fran-byte/MagSenseUI/doc/1.jpg

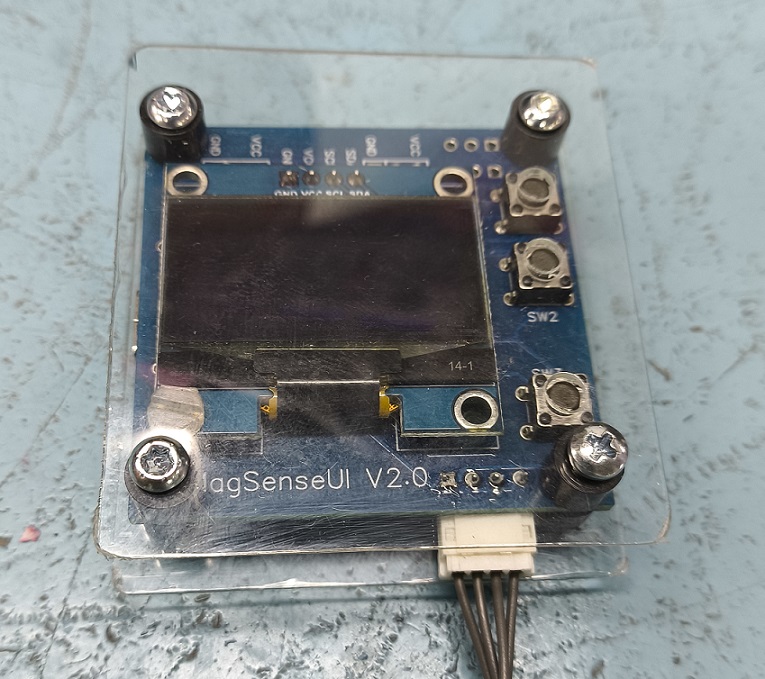
doc/1.jpg
