fran-byte/MagSenseUI/doc/3.jpg

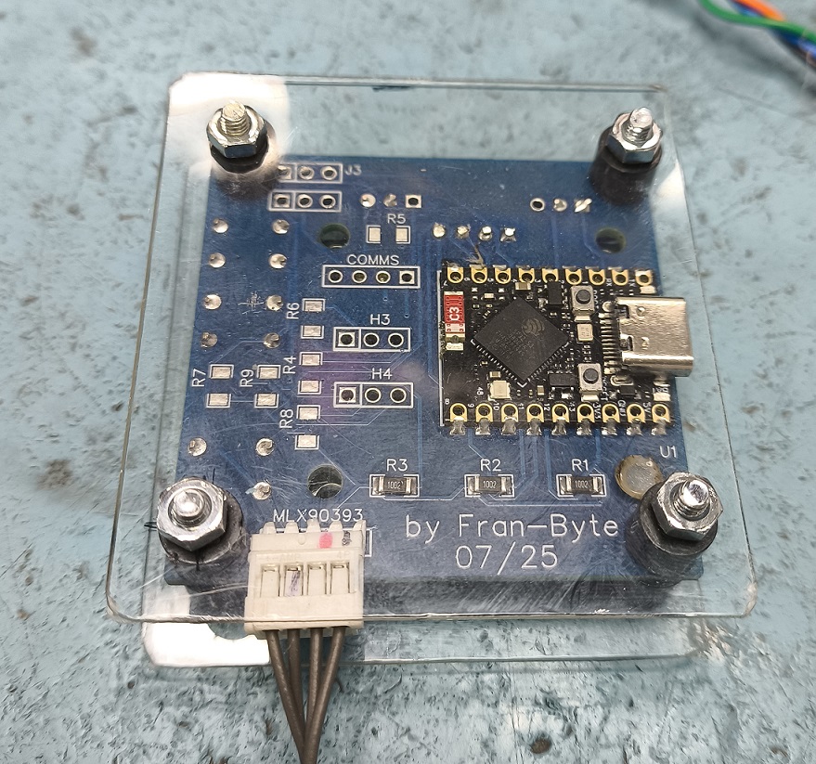
doc/3.jpg
