fran-byte/MagSenseUI/doc/3d.png

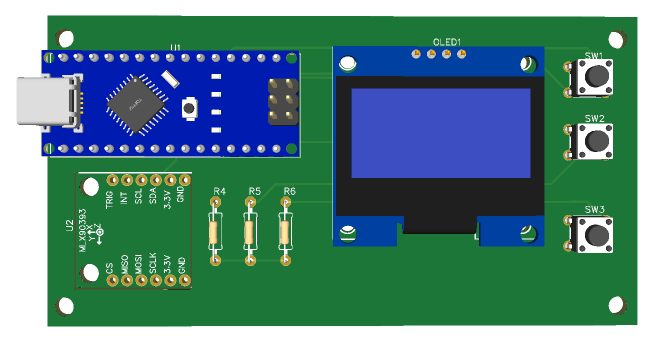
doc/3d.png
