fran-byte/MagSenseUI/doc/mlx90393.jpg

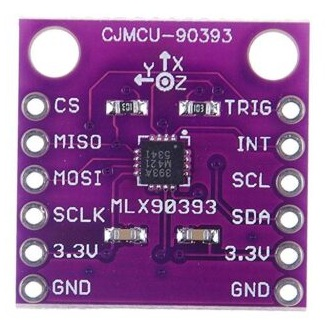
doc/mlx90393.jpg
