fran-byte/MagSenseUI/doc/show2.png

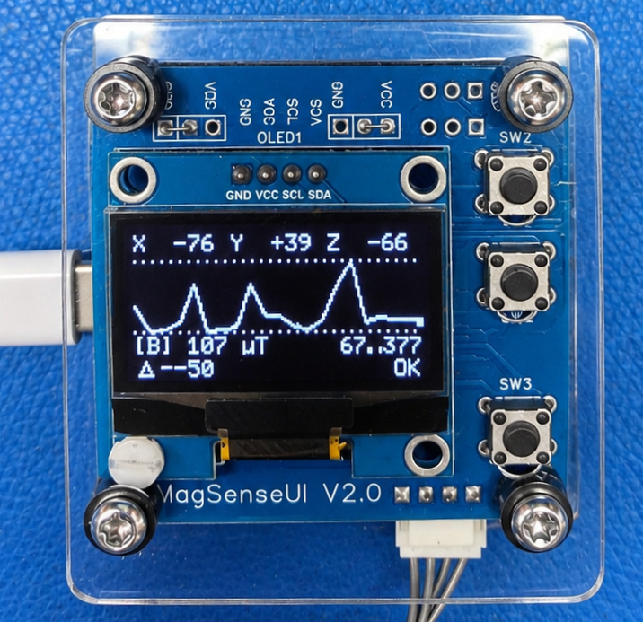
doc/show2.png
