fran-byte/MagSenseUI/doc/video.jpg

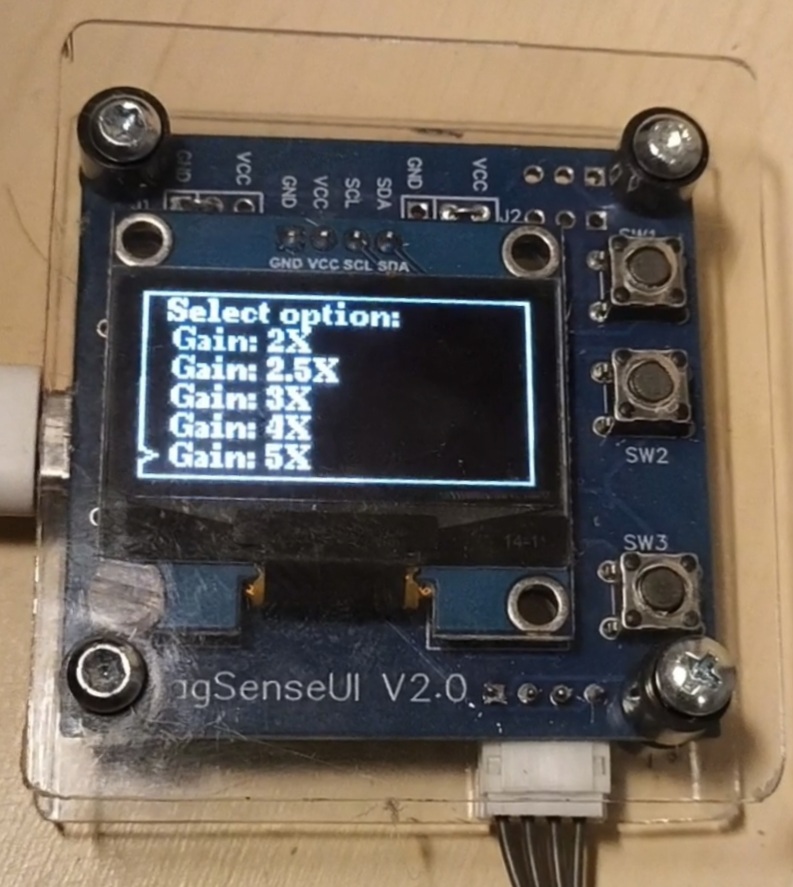
doc/video.jpg
