fran-byte/MagSenseUI/doc/video.png

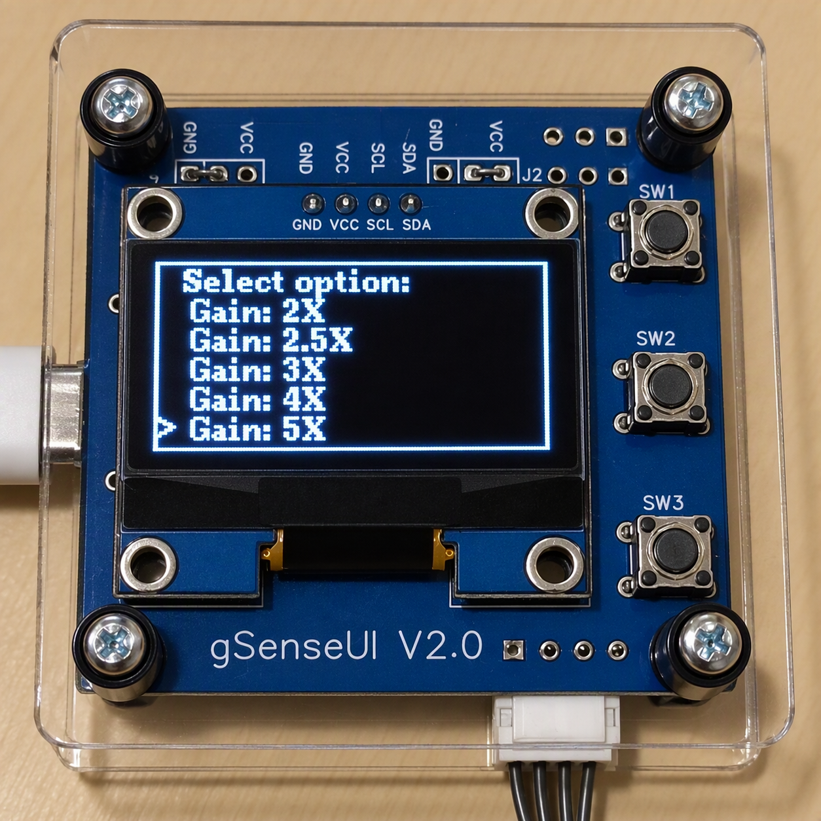
doc/video.png
