fran-byte/MagSenseUI/doc/x.png

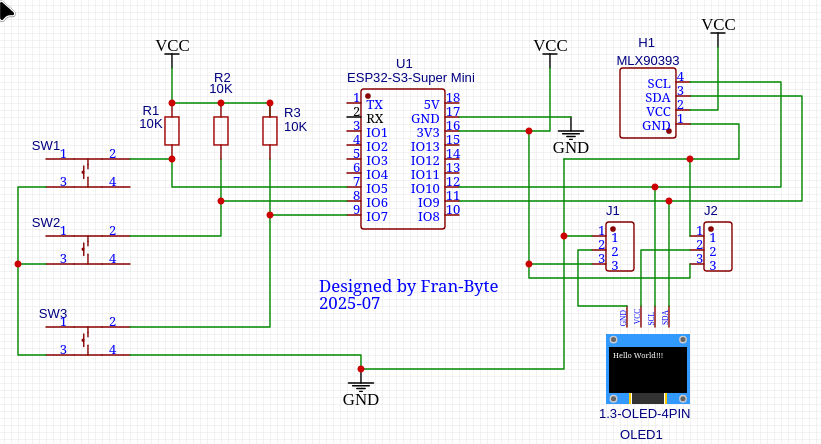
doc/x.png
