fran-byte/MagSenseUI/mg_board.jpg

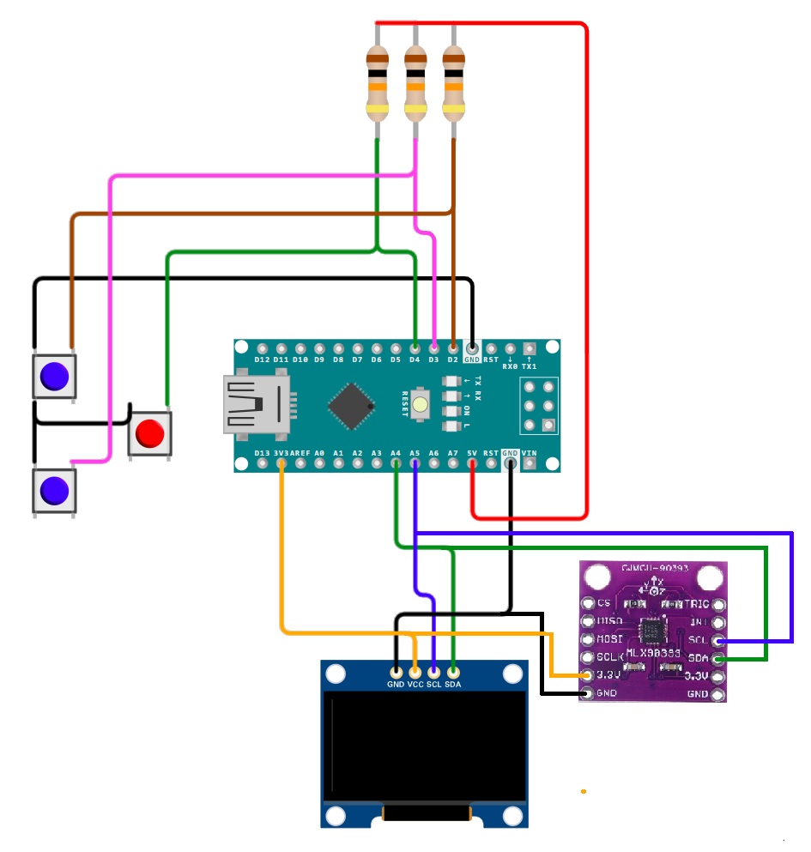
mg_board.jpg
