fran-byte/MagSenseUI/magSenseUi/iman_bitmap.h

#ifndef IMAN_BITMAP_H
#define IMAN_BITMAP_H
#include <Arduino.h>

#define IMAN128F_WIDTH  64
#define IMAN128F_HEIGHT 64

// '—Pngtree—vector magnet icon_4139931', 128x64px
const uint8_t imanAscii128x64_fixed[] PROGMEM = {
	0xff, 0xff, 0xff, 0xff, 0xff, 0xff, 0xff, 0xff, 0xff, 0xff, 0xff, 0xff, 0xff, 0xff, 0xff, 0xff, 
	0xff, 0xff, 0xff, 0xff, 0xff, 0xff, 0xff, 0xff, 0xff, 0xff, 0xff, 0xff, 0xff, 0xff, 0xff, 0xff, 
	0xff, 0xff, 0xff, 0xff, 0xff, 0xff, 0xff, 0xff, 0xff, 0xff, 0xff, 0xff, 0xff, 0xff, 0xff, 0xff, 
	0xff, 0xff, 0xff, 0xff, 0xff, 0xff, 0xff, 0xff, 0xff, 0xff, 0xff, 0xff, 0xff, 0xff, 0xff, 0xff, 
	0xff, 0xff, 0xff, 0xff, 0xe7, 0xff, 0xff, 0xff, 0xff, 0xff, 0xff, 0xff, 0xe3, 0xff, 0xff, 0xff, 
	0xff, 0xff, 0xff, 0xff, 0xf1, 0xff, 0xff, 0xff, 0xff, 0xff, 0xff, 0xff, 0xf0, 0xff, 0xff, 0xff, 
	0xff, 0xff, 0xff, 0x7f, 0xf0, 0xff, 0xff, 0xff, 0xff, 0x3f, 0xe0, 0x3f, 0xf8, 0x07, 0xfc, 0xff, 
	0xff, 0x1f, 0xe0, 0x1f, 0xf8, 0x07, 0xf8, 0xff, 0xff, 0x3f, 0xe0, 0x0f, 0xf8, 0x07, 0xf8, 0xff, 
	0xff, 0x3f, 0xe0, 0x07, 0xf8, 0x07, 0xf8, 0xff, 0xff, 0x3f, 0xe0, 0x03, 0x80, 0x07, 0xf8, 0xff, 
	0xff, 0x3f, 0xe0, 0x01, 0xc0, 0x07, 0xf8, 0xff, 0xff, 0x1f, 0xc0, 0x0f, 0xe0, 0x07, 0xf8, 0xff, 
	0xff, 0x3f, 0xe0, 0x3f, 0xf0, 0x07, 0xfc, 0xff, 0xff, 0xff, 0xff, 0x1f, 0xf8, 0xff, 0xff, 0xff, 
	0xff, 0x3f, 0xe0, 0x1f, 0xfc, 0x07, 0xfc, 0xff, 0xff, 0x1f, 0xc0, 0x0f, 0xfe, 0x07, 0xf8, 0xff, 
	0xff, 0x1f, 0xe0, 0x0f, 0xff, 0x07, 0xf8, 0xff, 0xff, 0x1f, 0xe0, 0x8f, 0xff, 0x07, 0xf8, 0xff, 
	0xff, 0x1f, 0xe0, 0xc7, 0xff, 0x07, 0xf8, 0xff, 0xff, 0x1f, 0xe0, 0xe7, 0xff, 0x07, 0xf8, 0xff, 
	0xff, 0x1f, 0xe0, 0xf3, 0xff, 0x07, 0xf8, 0xff, 0xff, 0x1f, 0xe0, 0xfb, 0xff, 0x07, 0xf8, 0xff, 
	0xff, 0x1f, 0xe0, 0xff, 0xff, 0x07, 0xf8, 0xff, 0xff, 0x1f, 0xe0, 0xff, 0xff, 0x07, 0xf8, 0xff, 
	0xff, 0x1f, 0xe0, 0xff, 0xff, 0x07, 0xf8, 0xff, 0xff, 0x1f, 0xe0, 0xff, 0xff, 0x07, 0xf8, 0xff, 
	0xff, 0x1f, 0xe0, 0xff, 0xff, 0x07, 0xf8, 0xff, 0xff, 0x1f, 0xe0, 0xff, 0xff, 0x07, 0xf8, 0xff, 
	0xff, 0x1f, 0xe0, 0xff, 0xff, 0x07, 0xf8, 0xff, 0xff, 0x1f, 0xe0, 0xff, 0xff, 0x07, 0xf8, 0xff, 
	0xff, 0x1f, 0xc0, 0xff, 0xff, 0x07, 0xf8, 0xff, 0xff, 0x3f, 0xc0, 0xff, 0xff, 0x03, 0xf8, 0xff, 
	0xff, 0x3f, 0xc0, 0xff, 0xff, 0x03, 0xfc, 0xff, 0xff, 0x3f, 0xc0, 0xff, 0xff, 0x03, 0xfc, 0xff, 
	0xff, 0x3f, 0x80, 0xff, 0xff, 0x01, 0xfc, 0xff, 0xff, 0x3f, 0x80, 0xff, 0xff, 0x01, 0xfc, 0xff, 
	0xff, 0x7f, 0x00, 0xff, 0xff, 0x00, 0xfe, 0xff, 0xff, 0x7f, 0x00, 0xfe, 0x3f, 0x00, 0xfe, 0xff, 
	0xff, 0xff, 0x00, 0xf8, 0x1f, 0x00, 0xff, 0xff, 0xff, 0xff, 0x00, 0xc0, 0x01, 0x00, 0xff, 0xff, 
	0xff, 0xff, 0x01, 0x00, 0x00, 0x80, 0xff, 0xff, 0xff, 0xff, 0x03, 0x00, 0x00, 0xc0, 0xff, 0xff, 
	0xff, 0xff, 0x07, 0x00, 0x00, 0xc0, 0xff, 0xff, 0xff, 0xff, 0x0f, 0x00, 0x00, 0xe0, 0xff, 0xff, 
	0xff, 0xff, 0x1f, 0x00, 0x00, 0xf8, 0xff, 0xff, 0xff, 0xff, 0x3f, 0x00, 0x00, 0xfc, 0xff, 0xff, 
	0xff, 0xff, 0xff, 0x00, 0x00, 0xff, 0xff, 0xff, 0xff, 0xff, 0xff, 0x03, 0xc0, 0xff, 0xff, 0xff, 
	0xff, 0xff, 0xff, 0xff, 0xff, 0xff, 0xff, 0xff, 0xff, 0xff, 0xff, 0xff, 0xff, 0xff, 0xff, 0xff, 
	0xff, 0xff, 0xff, 0xff, 0xff, 0xff, 0xff, 0xff, 0xff, 0xff, 0xff, 0xff, 0xff, 0xff, 0xff, 0xff, 
	0xff, 0xff, 0xff, 0xff, 0xff, 0xff, 0xff, 0xff, 0xff, 0xff, 0xff, 0xff, 0xff, 0xff, 0xff, 0xff, 
	0xff, 0xff, 0xff, 0xff, 0xff, 0xff, 0xff, 0xff, 0xff, 0xff, 0xff, 0xff, 0xff, 0xff, 0xff, 0xff
};



#endif
