fran-byte/MagSenseUI/(commit log)

2026-02-25 Add magnetic display to initialization sequence
2026-09-22 Refine description of MLX90393 magnetic sensor
2026-09-22 Revise alert levels and symbol explanations in README
    Updated alert levels and added explanation for symbols used in magnetic disturbance classification.
2026-11-04 Adjust frame and box dimensions in display_utils
2026-11-04 Remove I2C protocol details from README
    Removed detailed explanation of the I2C protocol and its clock signal.
2026-11-05 Enhance display logic with thresholds and diagnostics
    Added thresholds for warning and magnetization detection. Updated VU meter drawing logic to use calculated bars and display diagnostic line.
2026-11-13 feat: add peak-hold detection and configurable sampling interval
    - Add per-axis peak hold and hysteresis for magnetic alerts
    - Add tare support to reset the measurement, graph, and detector state
    - Add RGB LED status indicators for OK, warning, and magnetized states
    - Add configurable sampling interval and persist it in EEPROM
    - Update the menus, display refresh behavior, and README documentation
